R8bert/DC-DC-Regulators/Buck Converter (Step Down)/ME3116 W PWM/KiCad/plots/me3116 regulator__Assembly.pdf

L1 R⁴ | Q¹ | C1U¹ LED¹ | D¹ C2 | R7 R⁶ C3 | R² C4 | R¹ U4R3 U3 D2

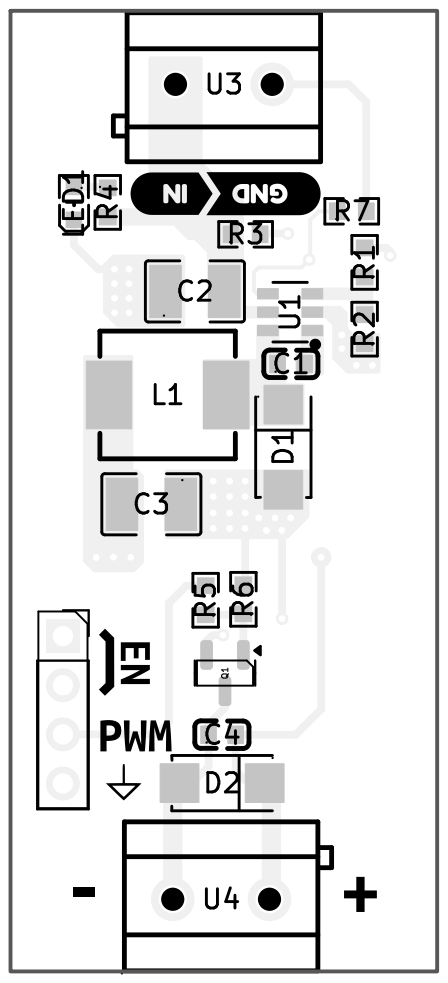
[picture p1: page 1]
D Date: KiCad; E.D.A. 9.0.2 Size: A4; Rev:; Id: /1 Title: File: me3116 regulator.kicad_pcb Sheet: Black; And; White; TOP; Board2Pdf:; Black; TOP -; Page

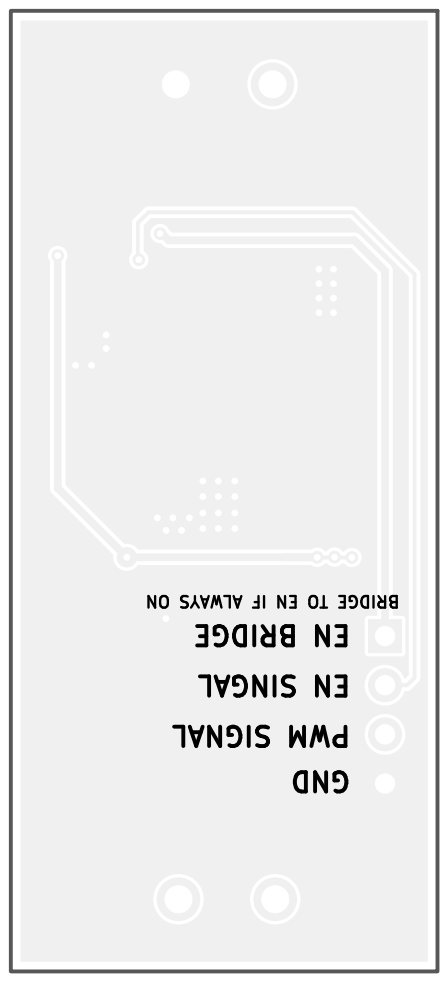
[picture p2: page 2]
D Date: KiCad; E.D.A. 9.0.2 Size: A4; Rev:; Id: /1 Title: File: me3116 regulator.kicad_pcb Sheet: Black; And; White; BOT Board2Pdf:; Black; BOT -; Page 2/2
