R8bert/DC-DC-Regulators/(list of files, drawings)

Other design files:
Buck Converter (Step Down)/LGS5145/KiCad/freerouting.dsn
Buck Converter (Step Down)/LGS5145/KiCad/temp-freerouting.dsn
Buck Converter (Step Down)/ME3116 W PWM/KiCad/freerouting.dsn
Buck Converter (Step Down)/ME3116/KiCad/temp-freerouting.dsn
