R8bert/DC-DC-Regulators/Buck Converter (Step Down)/ME3116 W PWM/KiCad/me3116 regulator.kicad_pcb

## KiCad design Buck Converter (Step Down)/ME3116 W PWM/KiCad/me3116 regulator.kicad_pcb (2025-11-05)

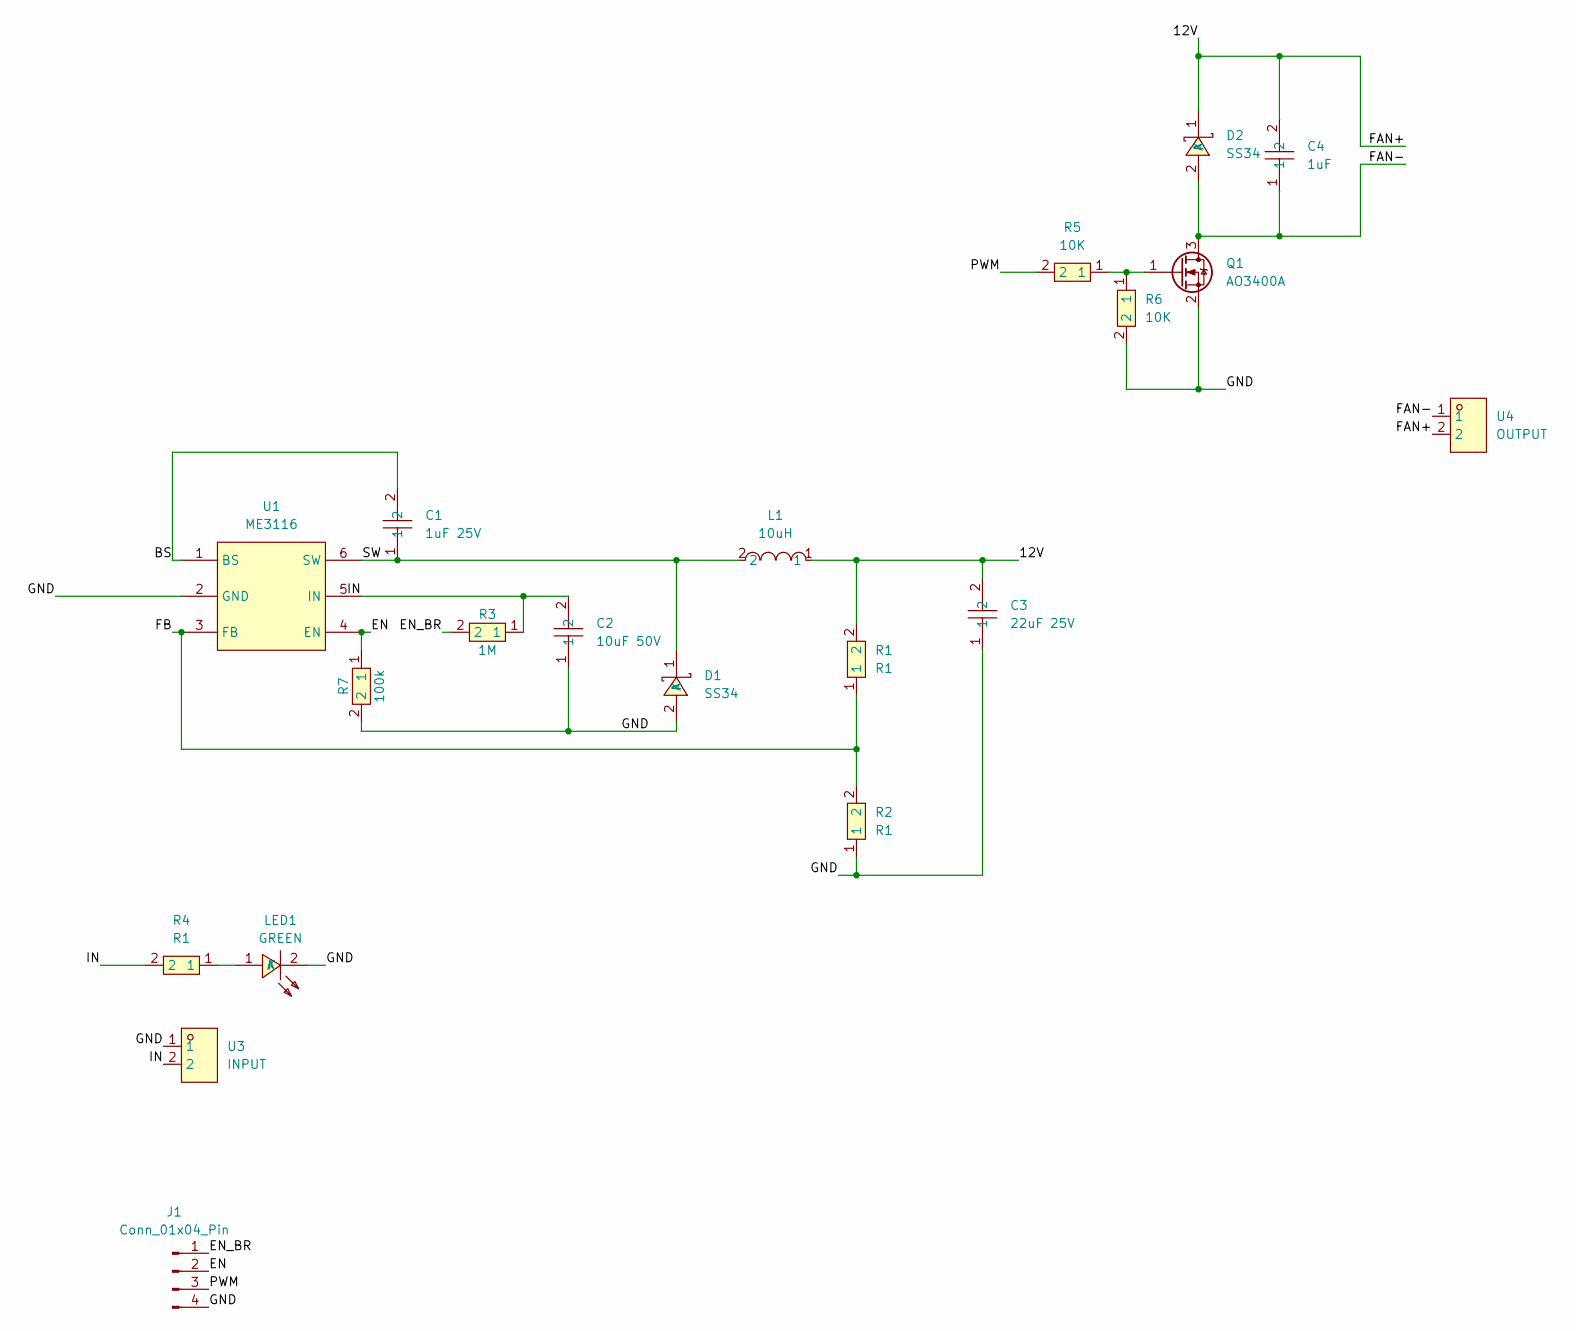
[picture p3: schematic me3116 regulator.kicad_sch]

Parts:
C1: 1uF 25V; C0603; LCSC Part C282519
C2: 10uF 50V; C1210; LCSC Part C2918502
C3: 22uF 25V; C1210; LCSC Part C2918502
C4: 1uF; C0603; LCSC Part C282519
D1, D2: SS34; SMA_L4.3-W2.6-LS5.2-RD; LCSC Part C8678
J1: Conn_01x04_Pin; PinSocket_1x04_P2.54mm_Vertical
L1: 10uH; IND-SMD_L7.0-W6.6_0630CDMCCDS; LCSC Part C2961890
LED1: GREEN; LED0603-R-RD; LCSC Part C205450
Q1: AO3400A; SOT-23
R1, R2, R4: R1; R0603; LCSC Part C2918515
R3: 1M; R0603; LCSC Part C2918515
R5, R6: 10K; R0603; LCSC Part C2918515
R7: 100k; R0603; LCSC Part C2918515
U1: ME3116; SOT-23-6_L2.9-W1.6-P0.95-LS2.8-BL; LCSC Part C97643
U3: INPUT; CONN-TH_P5.00_KF301-5.0-2P; LCSC Part C474881
U4: OUTPUT; CONN-TH_P5.00_KF301-5.0-2P; LCSC Part C474881

Connections:
/12V: C3.2, C4.2, D2.1 (K), L1.1, R1.2, U4.2
/BS: C1.2, U1.1 (BS)
/EN: J1.2, R7.1, U1.4 (EN)
/EN_BR: J1.1, R3.2
/FAN-: C4.1, D2.2 (A), Q1.3 (D), U4.1
/FB: R1.1, R2.2, U1.3 (FB)
/GND: C2.1, C3.1, D1.2 (A), J1.4, LED1.2 (K), Q1.2 (S), R2.1, R6.2, R7.2, U1.2 (GND), U3.1
/IN: C2.2, R3.1, R4.2, U1.5 (IN), U3.2
/PWM: J1.3, R5.2
/SW: C1.1, D1.1 (K), L1.2, U1.6 (SW)
unnamed: LED1.1 (A), R4.1
unnamed: Q1.1 (G), R5.1, R6.1

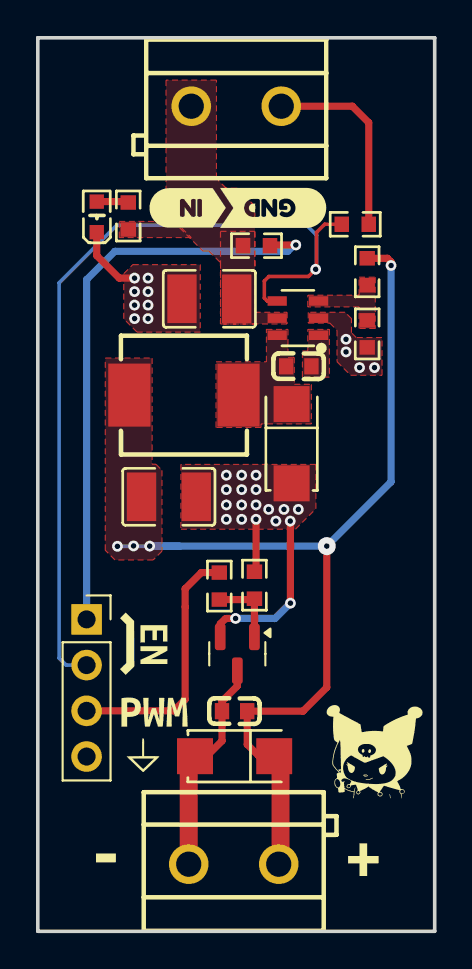
[picture p4: board me3116 regulator.kicad_pcb from above]

Board: 2 copper layers, 22.0 x 49.6 mm, 26 parts (0 on the bottom side), 12 nets.

Other parts of the board:
kibuzzard-67E9F36D: G***; kibuzzard-67E9F36D
kibuzzard-67E9F317: G***; kibuzzard-67E9F317
kibuzzard-67F7E74D: G***; kibuzzard-67F7E74D
kibuzzard-67F7E75E: G***; kibuzzard-67F7E75E
kibuzzard-68139A75: G***; kibuzzard-68139A75
kibuzzard-68139A87: G***; kibuzzard-68139A87
